RobertLWalton/RobertLWalton.github.io/LSC/North-Acton-Map/North-Acton-2023-08-13-Spring-Hill-5.pdf

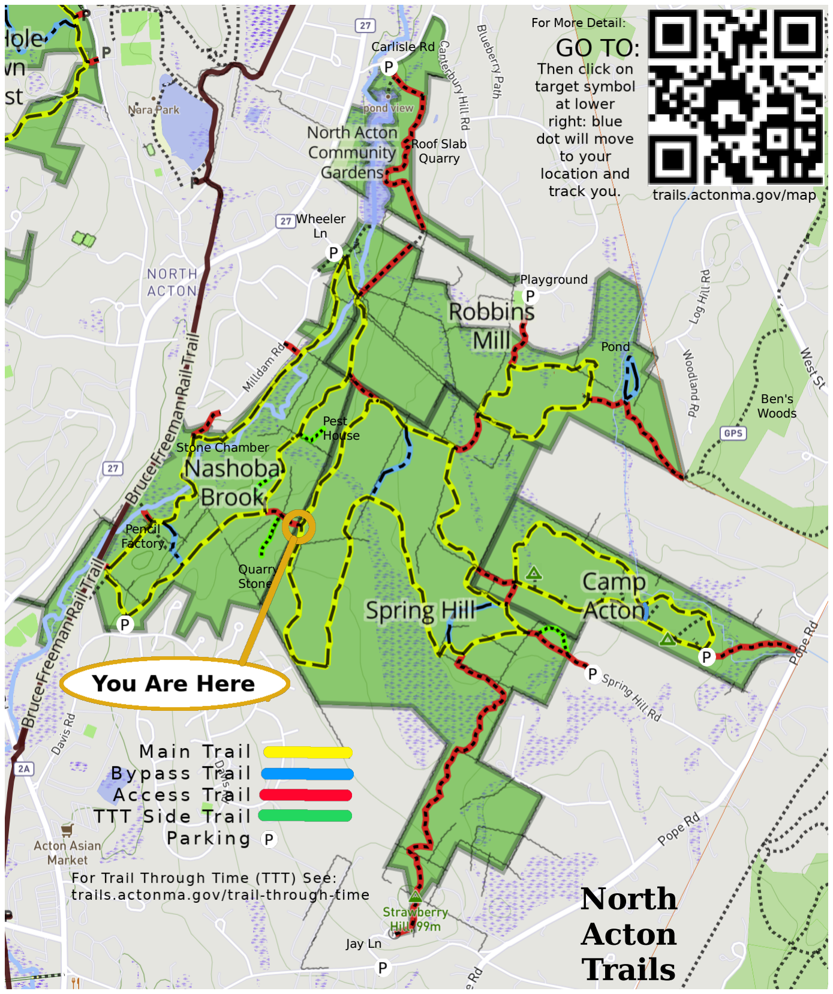
[picture p23: page 1]

Carlisle Rd

Playground

Wheeler
Ln

Pond

Pest
House
Stone Chamber

Quarry
Stone

Pencil
Factory

Jay Ln

Ben's
Woods

Roof Slab
Quarry

# North Acton Trails
