RobertLWalton/RobertLWalton.github.io/LSC/North-Acton-Map/North-Acton-2023-08-13-Robbins-Mill-3.pdf

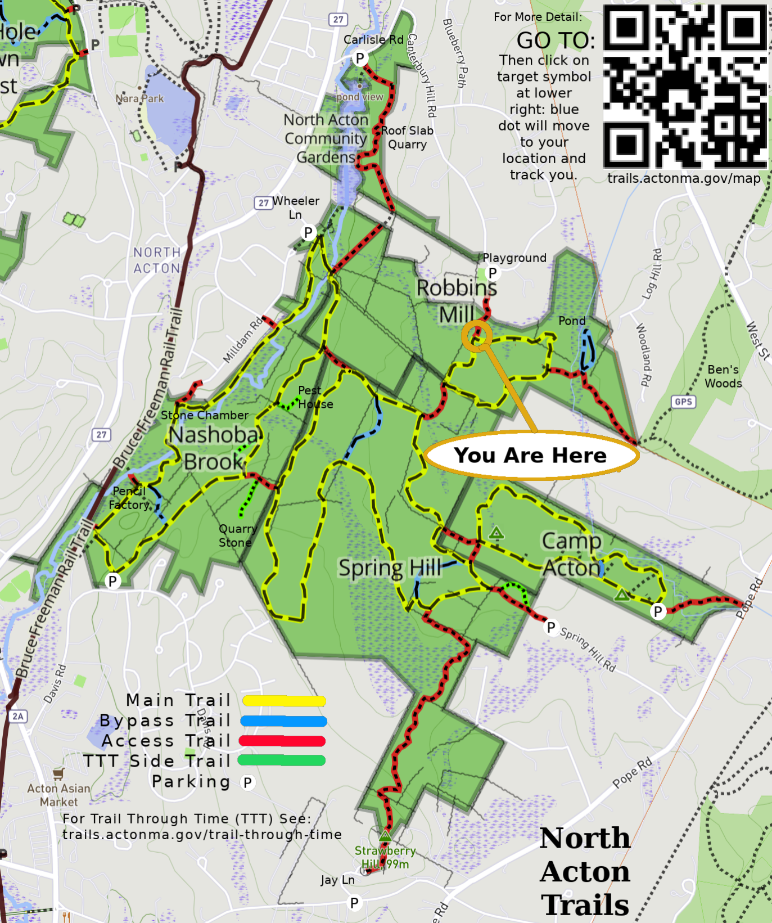
[picture p24: page 1]
