RobertLWalton/RobertLWalton.github.io/LSC/Wills-Hole-Map/Wills-Hole-2025-04-04-4.pdf

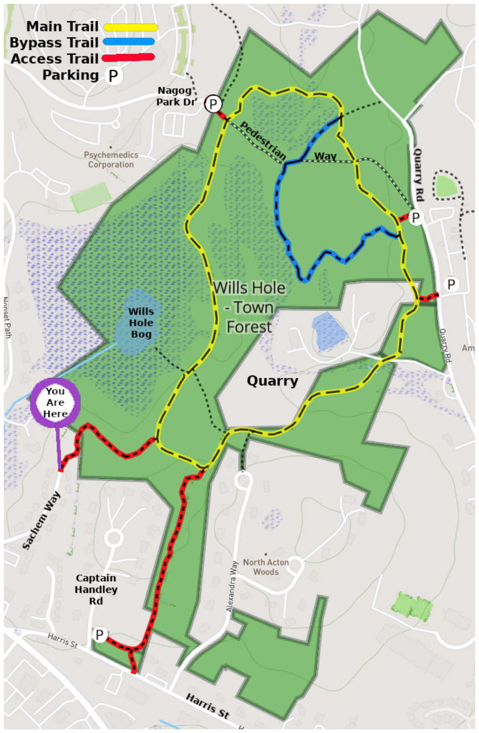
[picture p25: page 1]
