RobertLWalton/RobertLWalton.github.io/LSC/Wills-Hole-Map/Wills-Hole-2025-04-04-1.pdf

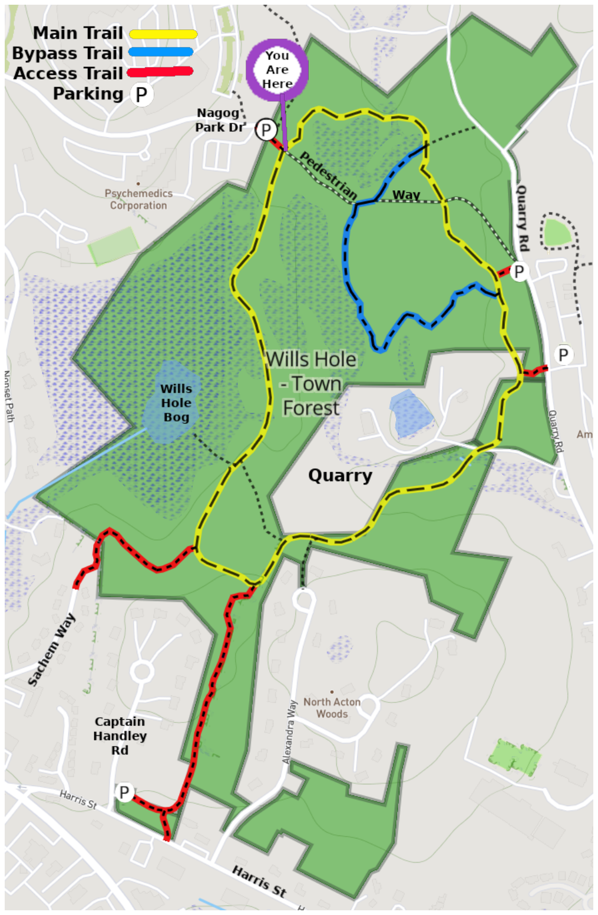
[picture p26: page 1]
