RobertLWalton/RobertLWalton.github.io/LSC/Wills-Hole-Map/Wills-Hole-2025-04-04-2.pdf

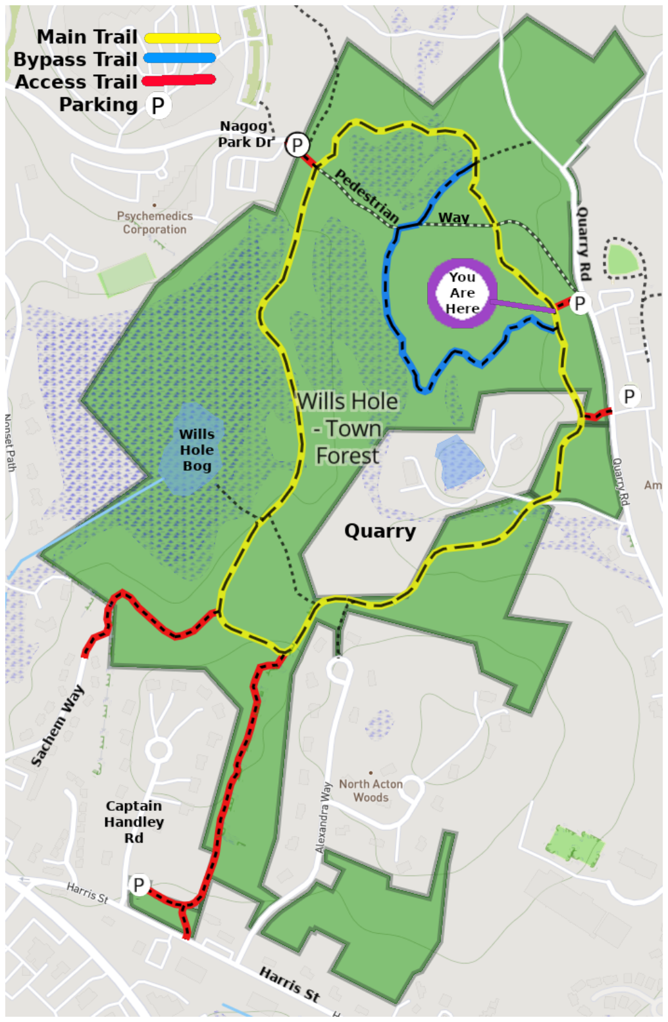
[picture p27: page 1]
