RobertLWalton/RobertLWalton.github.io/LSC/Wills-Hole-Map/Wills-Hole-2025-04-04-3.pdf

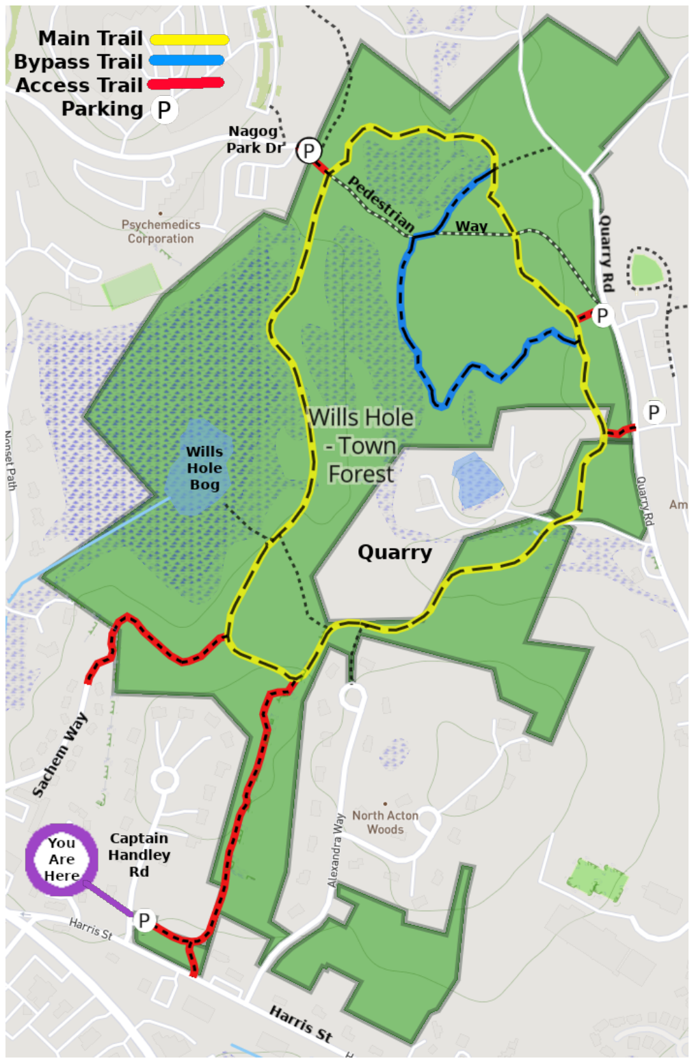
[picture p28: page 1]
