RobertLWalton/RobertLWalton.github.io/LSC/Wills-Hole-Map/Wills-Hole-Labeled-Here.pdf

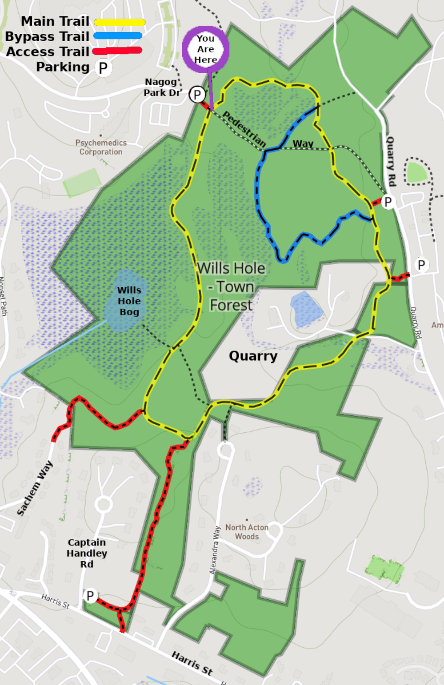
[picture p29: page 1]
