RobertLWalton/RobertLWalton.github.io/LSC/Wills-Hole-Map/Wills-Hole-Labeled.pdf

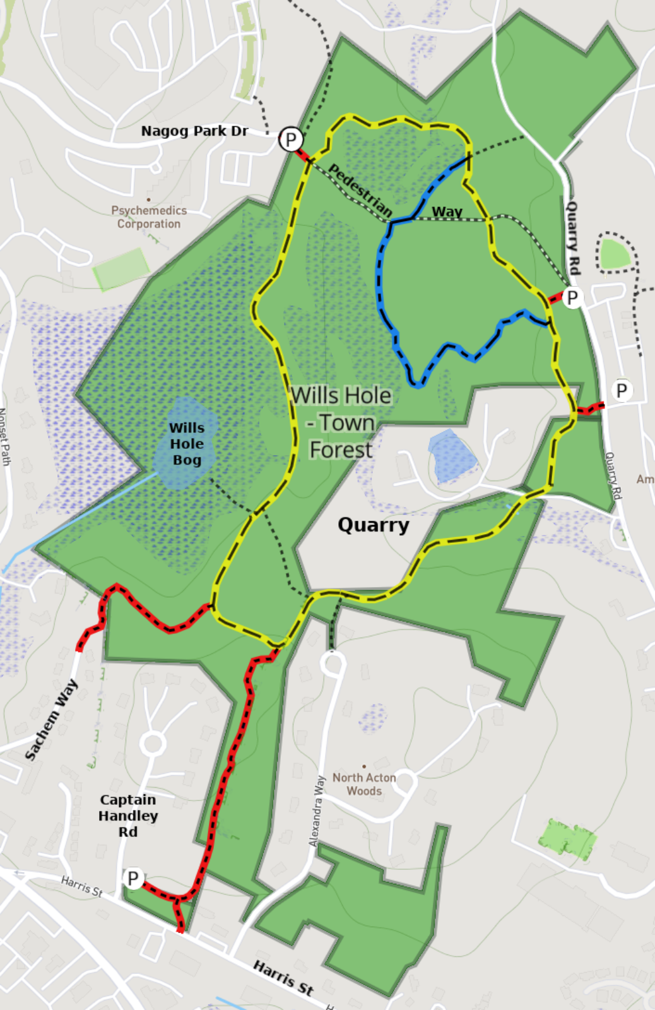
[picture p30: page 1]
