RobertLWalton/RobertLWalton.github.io/LSC/Wills-Hole-Map/Wills-Hole-Base.pdf

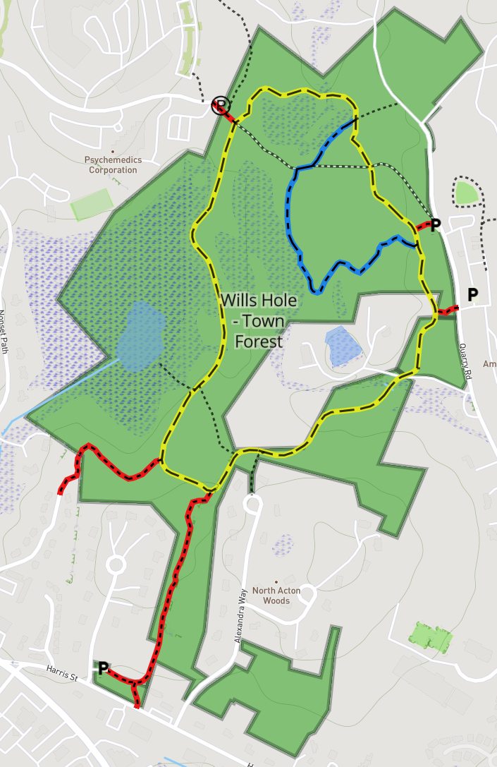
[picture p31: page 1]
