RobertLWalton/RobertLWalton.github.io/LSC/North-Acton-Map/North-Acton-2023-08-13-Spring-Hill-1.pdf

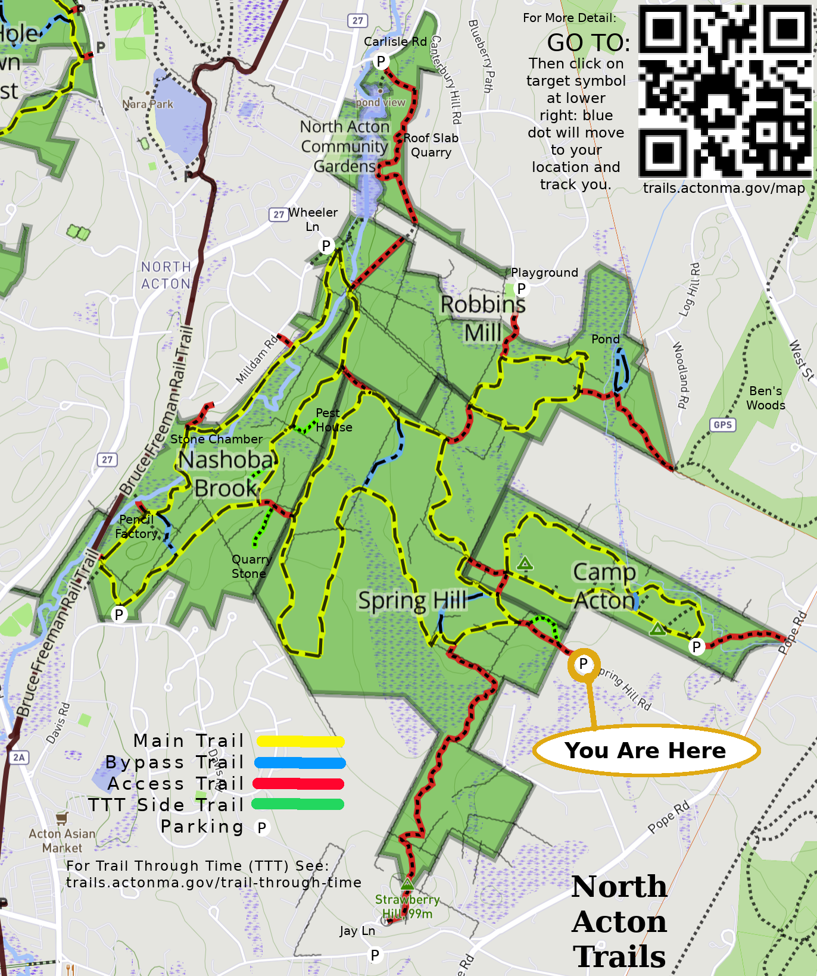
[picture p32: page 1]
