RobertLWalton/RobertLWalton.github.io/LSC/North-Acton-Map/North-Acton-2023-08-13-Spring-Hill-2.pdf

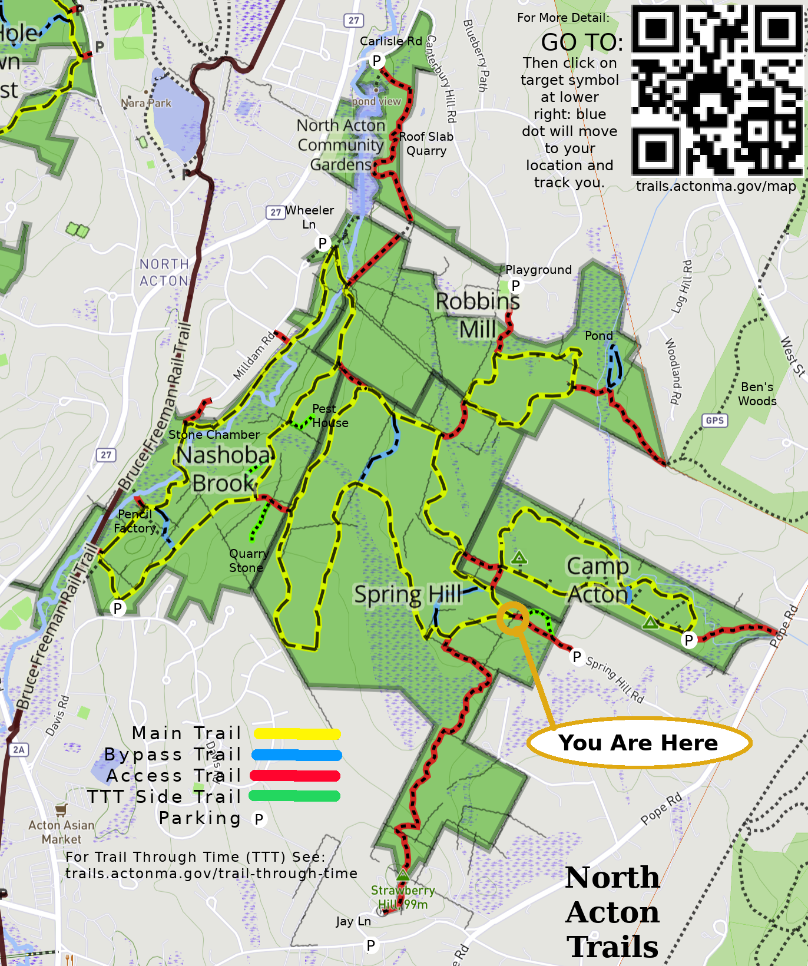
[picture p33: page 1]
