RobertLWalton/RobertLWalton.github.io/LSC/North-Acton-Map/North-Acton-2023-08-13-Spring-Hill-3.pdf

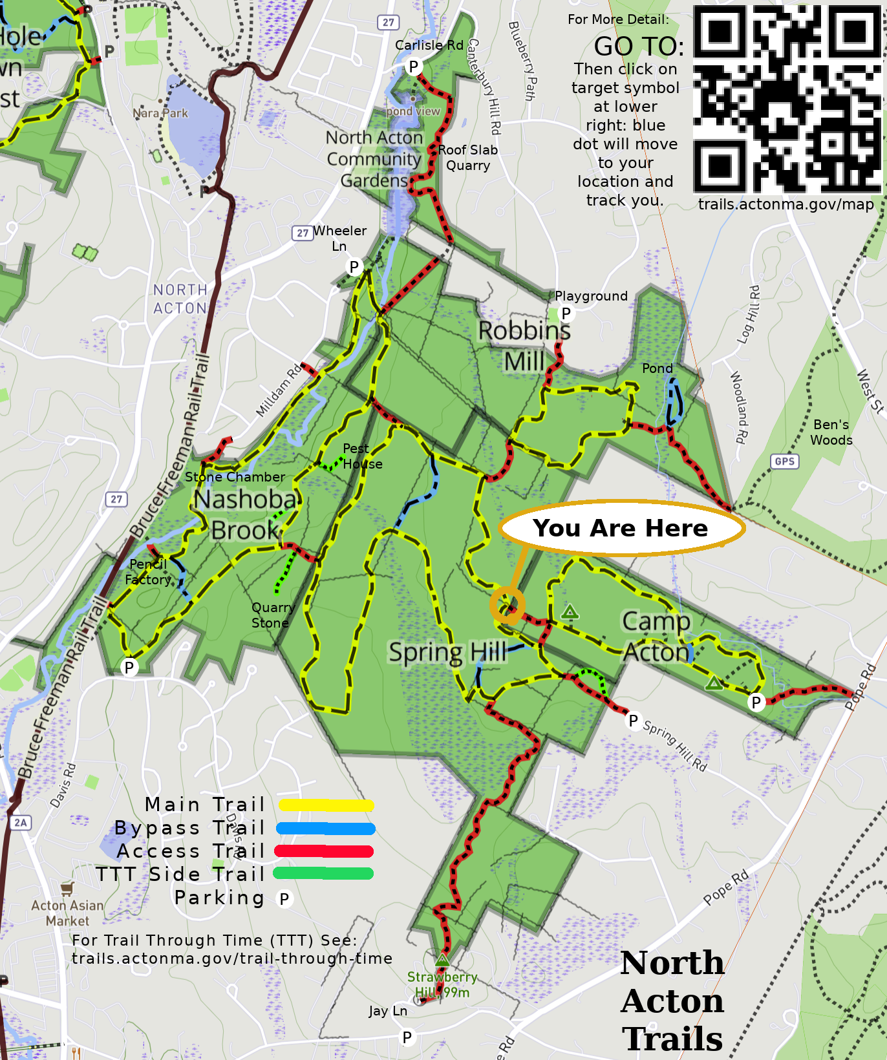
[picture p34: page 1]
