RobertLWalton/RobertLWalton.github.io/LSC/North-Acton-Map/North-Acton-2023-08-13-Spring-Hill-4.pdf

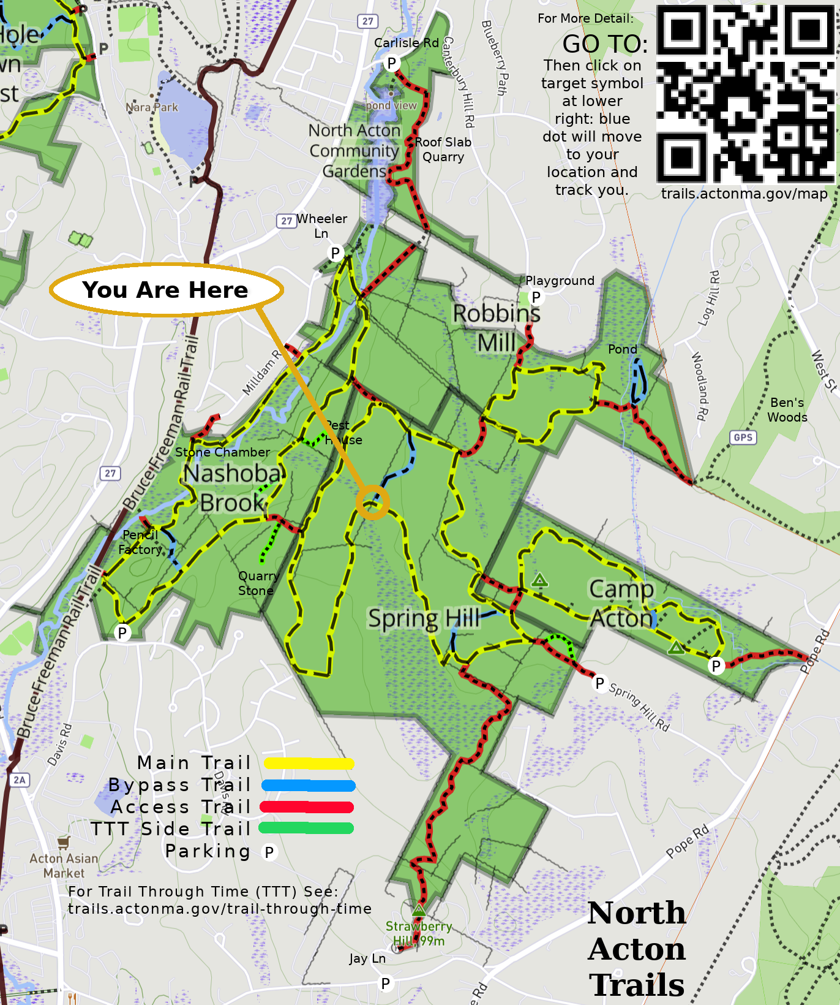
[picture p35: page 1]
