RobertLWalton/RobertLWalton.github.io/LSC/North-Acton-Map/North-Acton-2023-08-13-Robbins-Mill-1.pdf

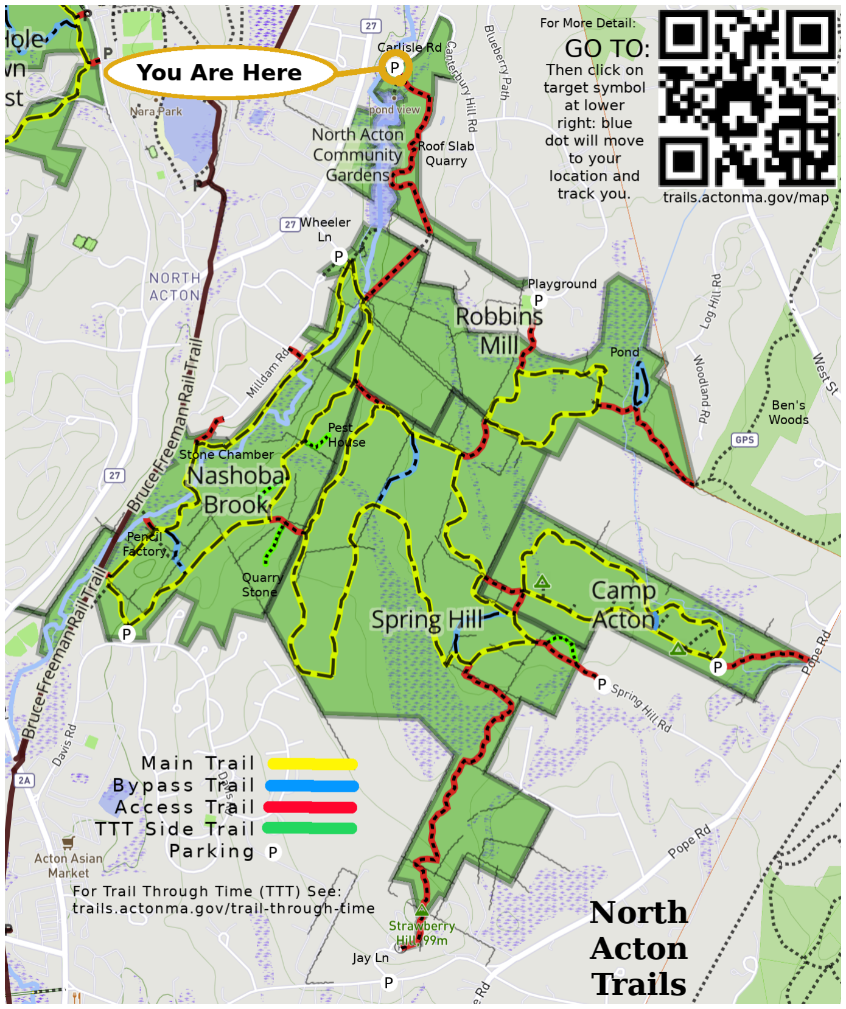
[picture p36: page 1]
