RobertLWalton/RobertLWalton.github.io/LSC/North-Acton-Map/North-Acton-2023-08-13-Robbins-Mill-2.pdf

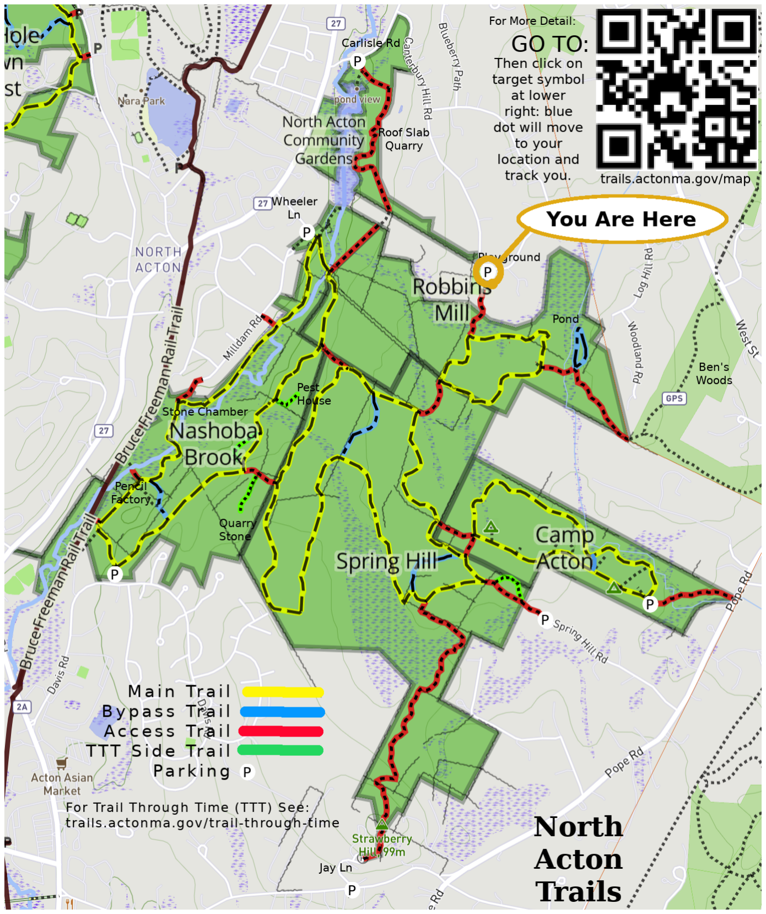
[picture p37: page 1]
