RobertLWalton/RobertLWalton.github.io/LSC/North-Acton-Map/North-Acton-2023-08-13-Labelled-with-Blue-Trail.pdf

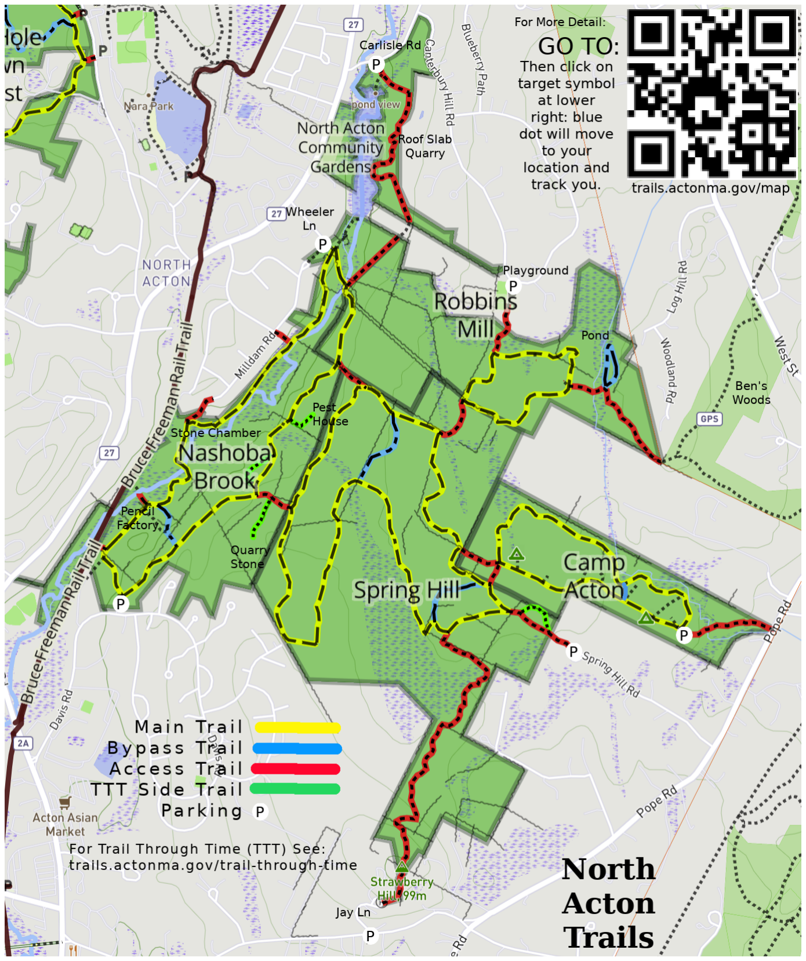
[picture p39: page 1]
