RobertLWalton/RobertLWalton.github.io/LSC/robbins-mill/scout-trust-land/scout-trust-re-route-map.pdf

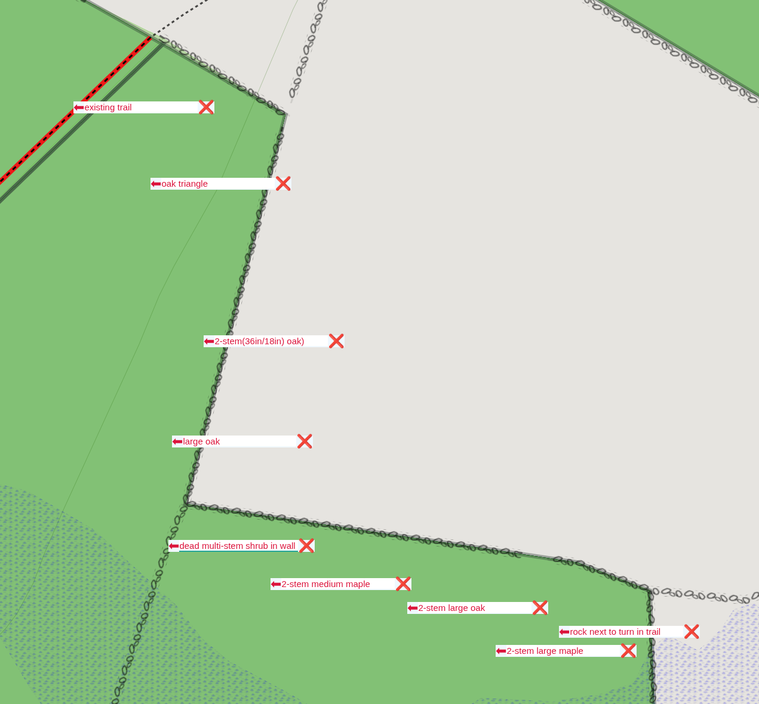
[picture p40: page 1]
