RobertLWalton/RobertLWalton.github.io/LSC/robbins-mill/scout-trust-land/scout-trust-re-route.pdf

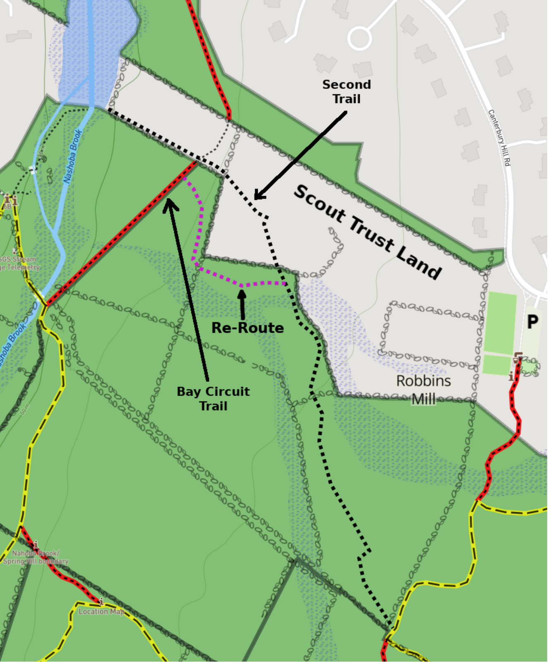
[picture p41: page 1]
