RobertLWalton/RobertLWalton.github.io/LSC/robbins-mill/scout-trust-land/scout-trust-land.pdf

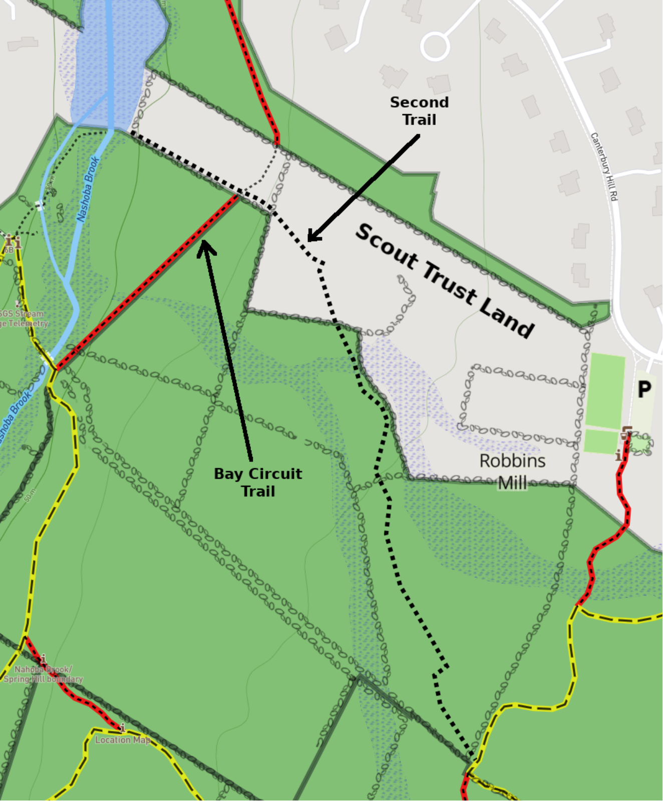
[picture p42: page 1]
