RobertLWalton/RobertLWalton.github.io/LSC/boardwalk/Boardwalk-bottom.png

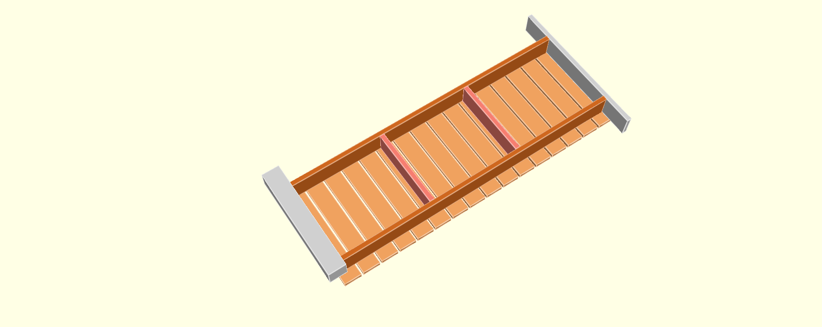
LSC/boardwalk/Boardwalk-bottom.png
