RobertLWalton/RobertLWalton.github.io/LSC/boardwalk/Boardwalk-end.png

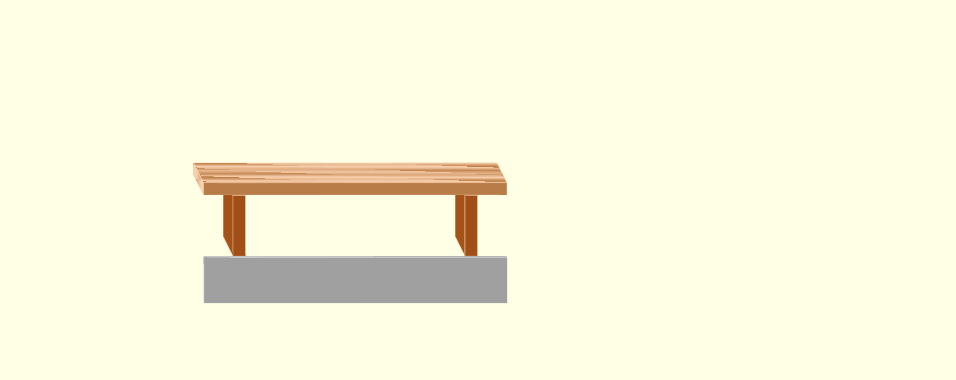
LSC/boardwalk/Boardwalk-end.png
