RobertLWalton/RobertLWalton.github.io/LSC/boardwalk/Boardwalk-side.png

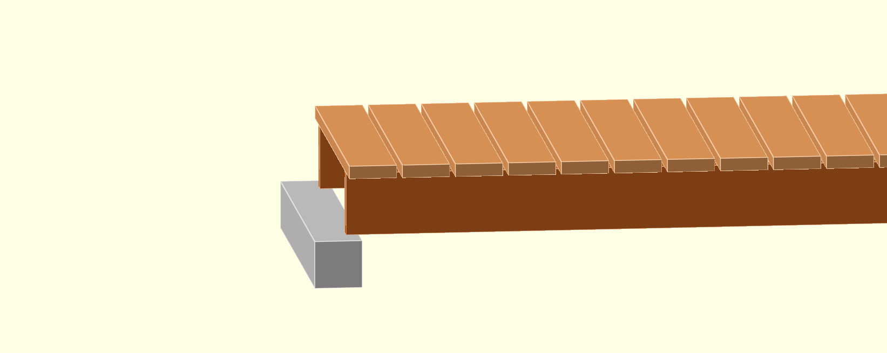
LSC/boardwalk/Boardwalk-side.png
