RobertLWalton/RobertLWalton.github.io/LSC/boardwalk/Boardwalk-sill-height.png

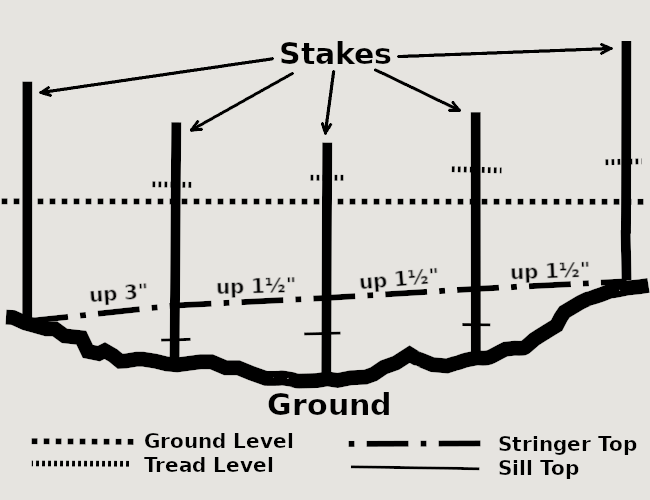
LSC/boardwalk/Boardwalk-sill-height.png
