RobertLWalton/RobertLWalton.github.io/LSC/boardwalk/Boardwalk-top.png

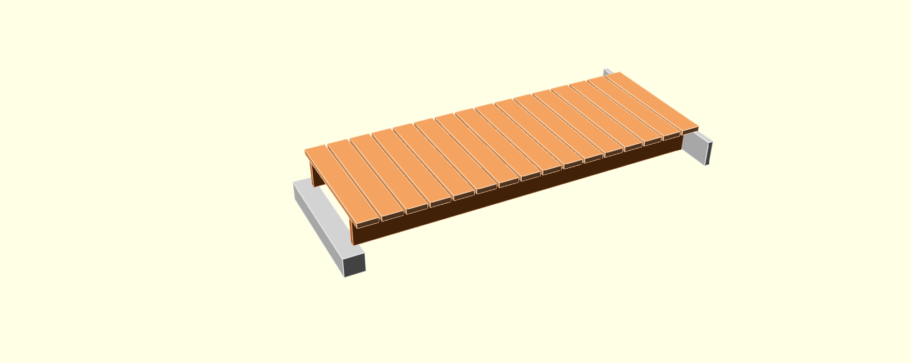
LSC/boardwalk/Boardwalk-top.png
