RobertLWalton/RobertLWalton.github.io/LSC/boardwalk/corner-long-stringers.png

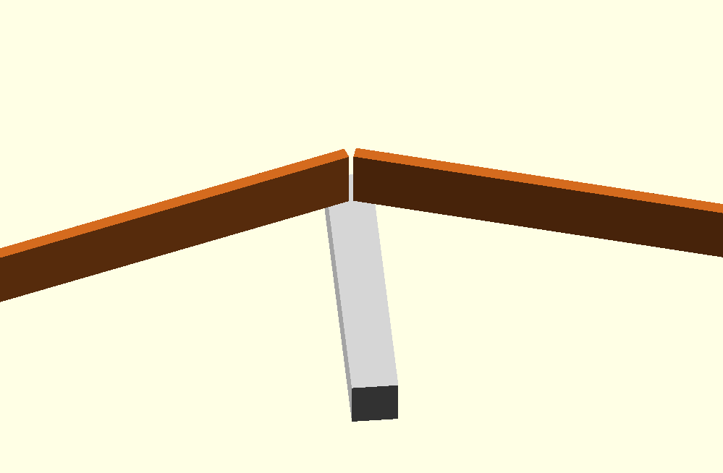
LSC/boardwalk/corner-long-stringers.png
