RobertLWalton/RobertLWalton.github.io/LSC/boardwalk/corner-stringers.png

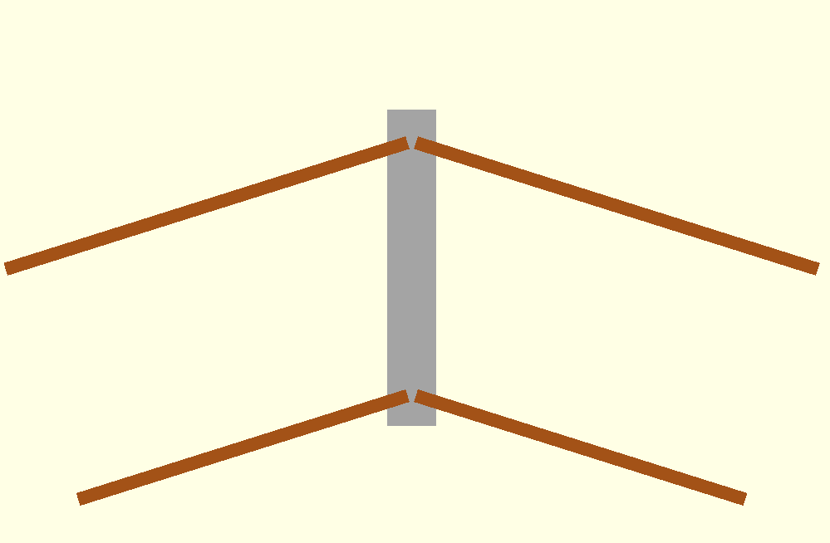
LSC/boardwalk/corner-stringers.png
