RobertLWalton/RobertLWalton.github.io/LSC/boardwalk/corner-treads.png

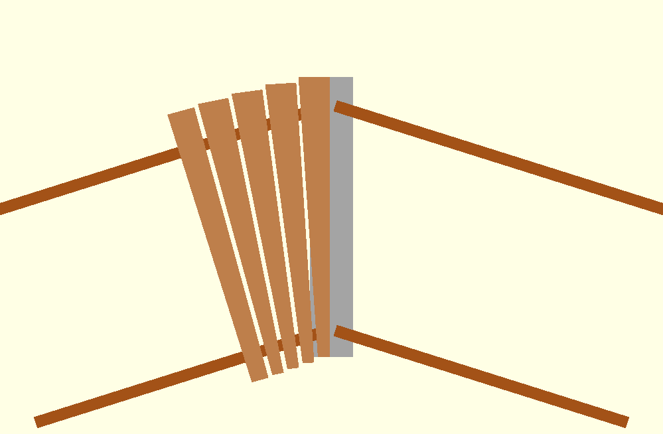
LSC/boardwalk/corner-treads.png
