RobertLWalton/RobertLWalton.github.io/LSC/boardwalk/corner.png

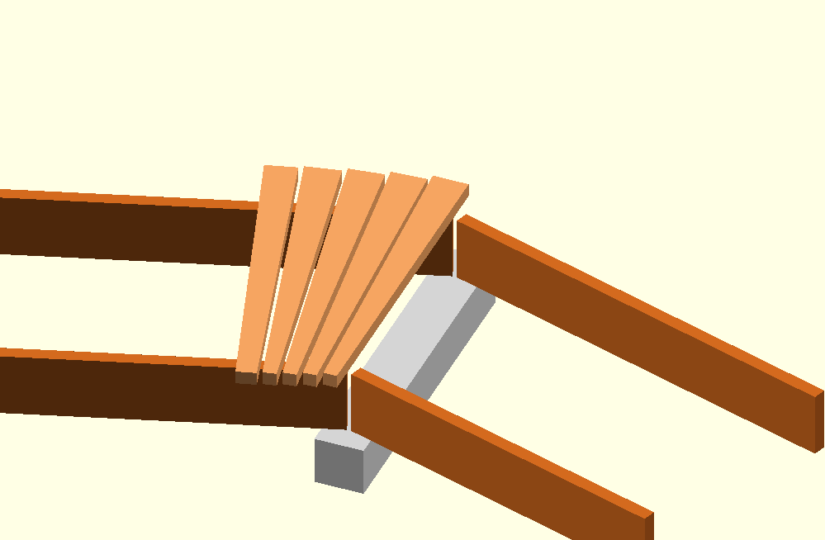
LSC/boardwalk/corner.png
