RobertLWalton/RobertLWalton.github.io/LSC/boardwalk/stringer-length.png

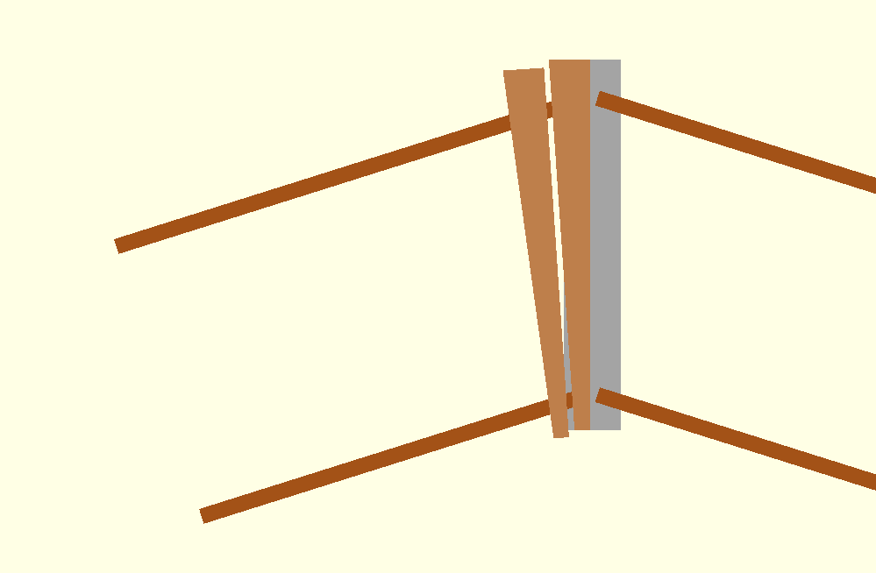
LSC/boardwalk/stringer-length.png
