RobertLWalton/RobertLWalton.github.io/LSC/boardwalk/tapered.png

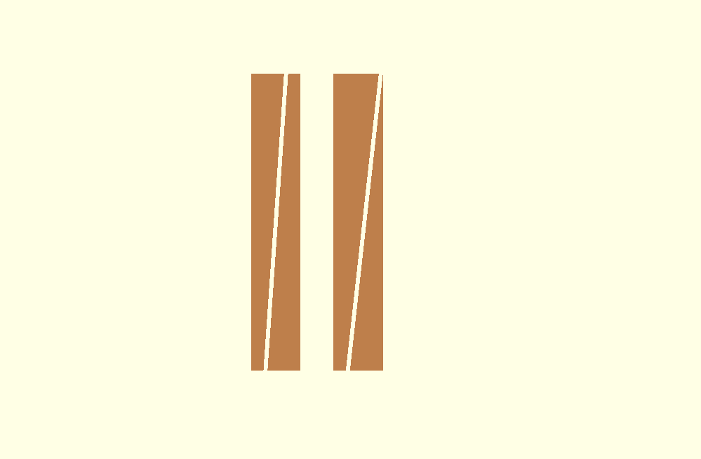
LSC/boardwalk/tapered.png
