RobertLWalton/RobertLWalton.github.io/LSC/bridge/Bridge-CAD.png

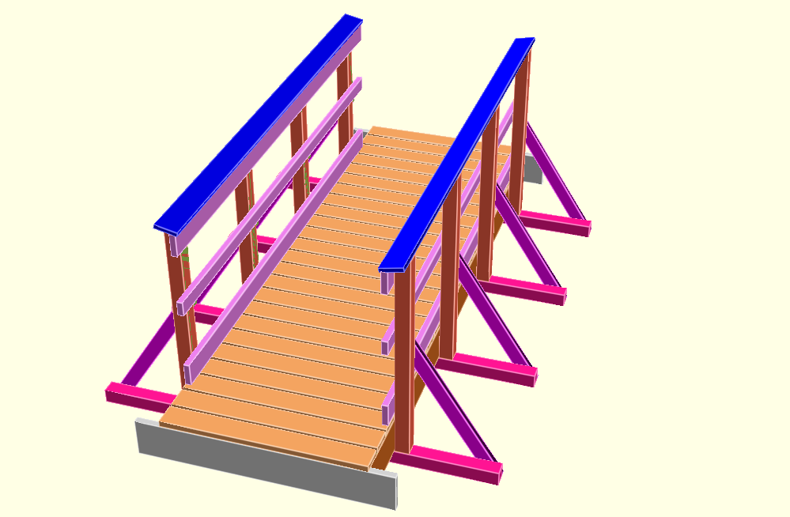
LSC/bridge/Bridge-CAD.png
