RobertLWalton/RobertLWalton.github.io/LSC/bridge/Bridge-Frame-Bottom-CAD.png

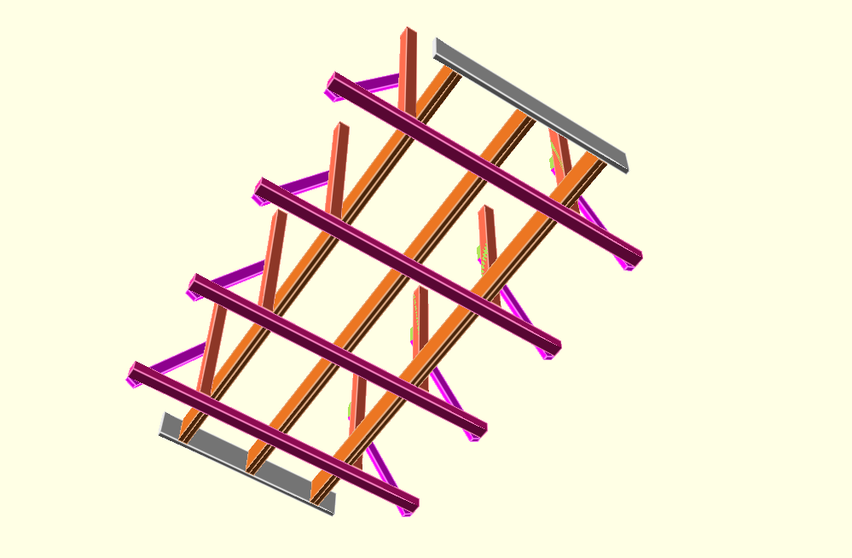
LSC/bridge/Bridge-Frame-Bottom-CAD.png
