RobertLWalton/RobertLWalton.github.io/LSC/bridge/Bridge-Frame-Bottom.png

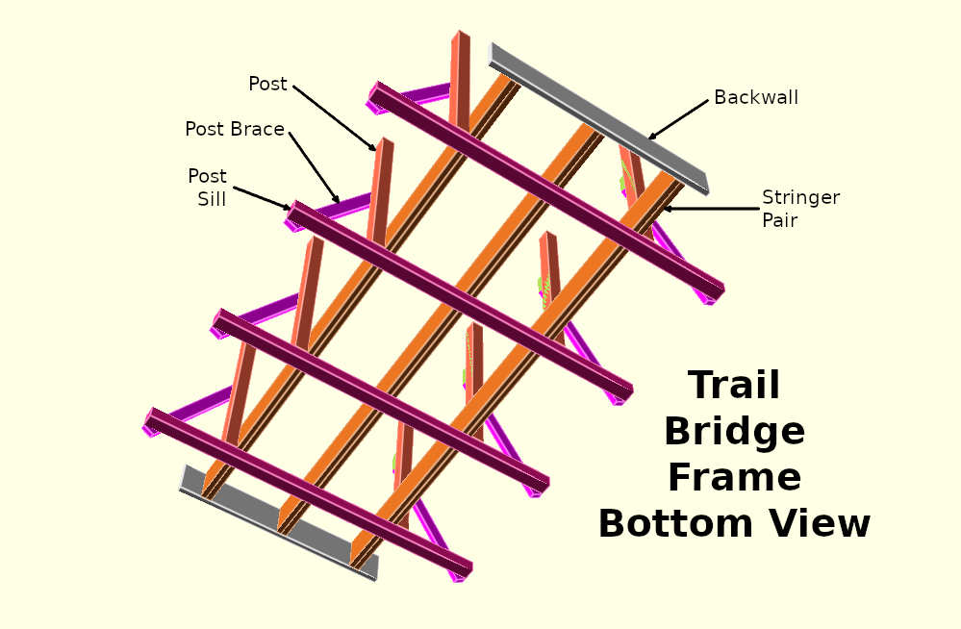
LSC/bridge/Bridge-Frame-Bottom.png
