RobertLWalton/RobertLWalton.github.io/LSC/bridge/Bridge-Frame-Rails-Caps.png

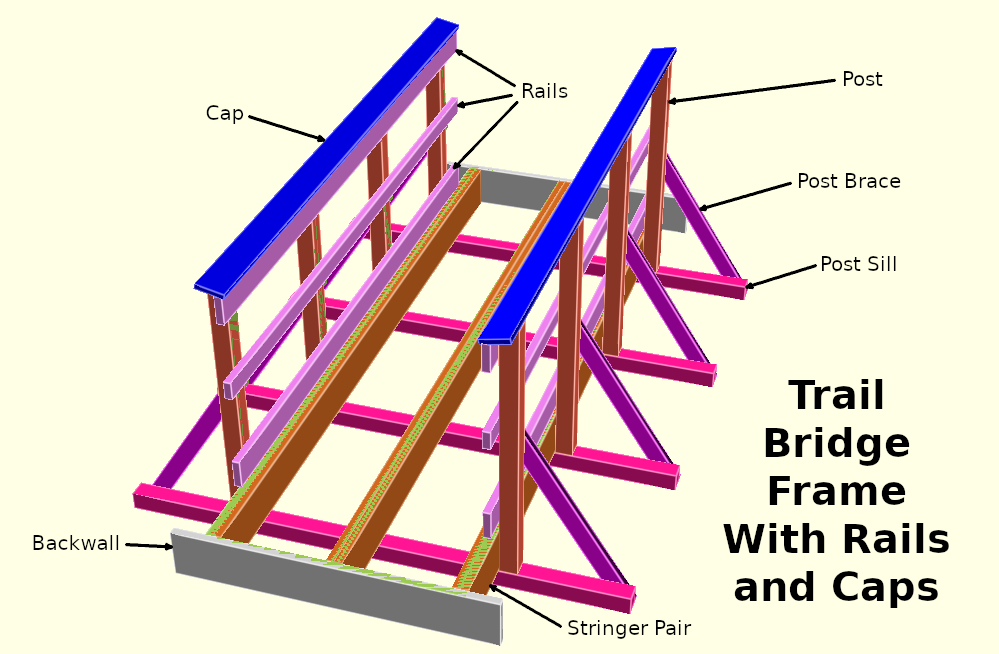
LSC/bridge/Bridge-Frame-Rails-Caps.png
