RobertLWalton/RobertLWalton.github.io/LSC/bridge/Bridge-Frame-Top-CAD.png

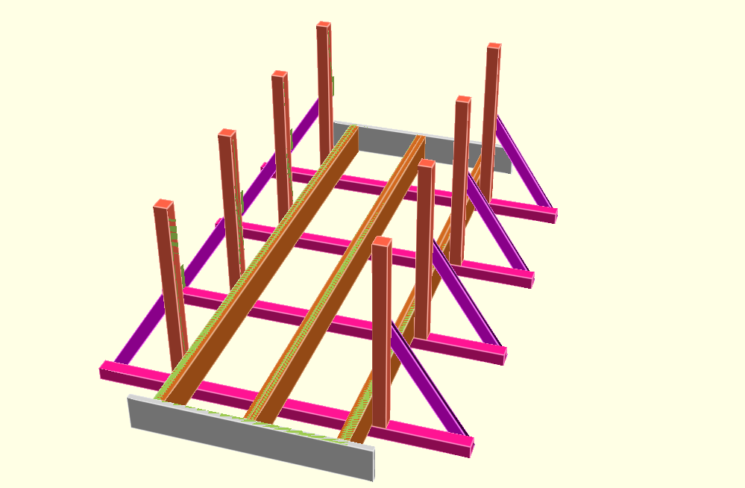
LSC/bridge/Bridge-Frame-Top-CAD.png
