RobertLWalton/RobertLWalton.github.io/LSC/bridge/Bridge-Frame-Top.png

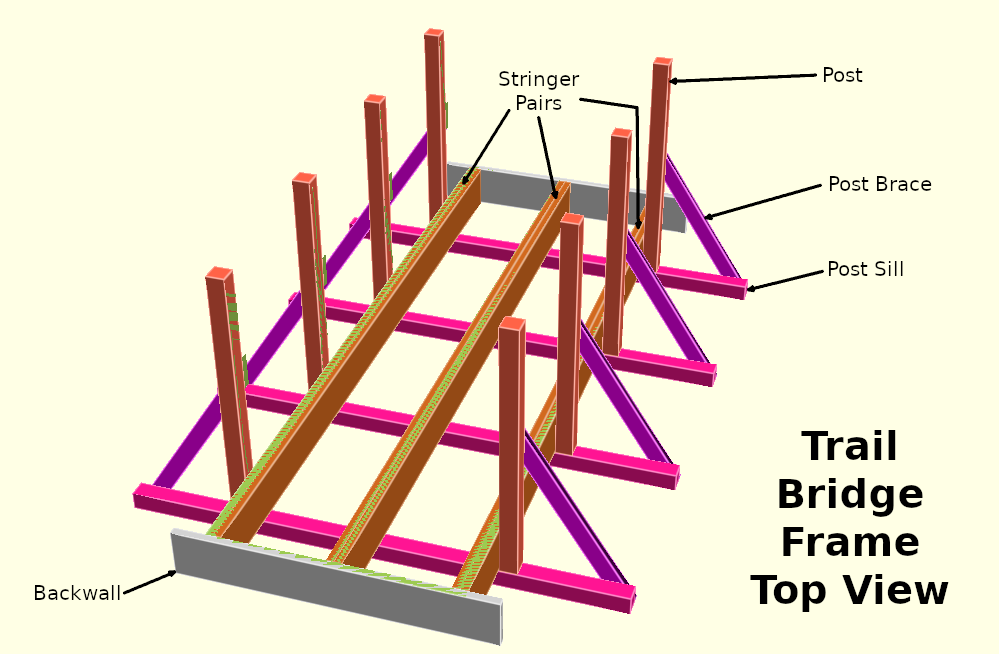
LSC/bridge/Bridge-Frame-Top.png
