RobertLWalton/RobertLWalton.github.io/LSC/bridge/EPC4Z-Bare.png

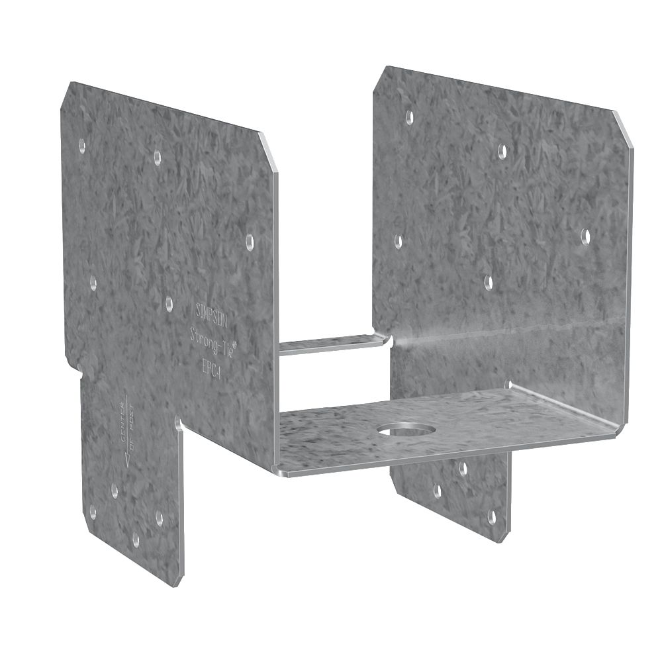
LSC/bridge/EPC4Z-Bare.png
