RobertLWalton/RobertLWalton.github.io/LSC/bridge/EPC4Z.png

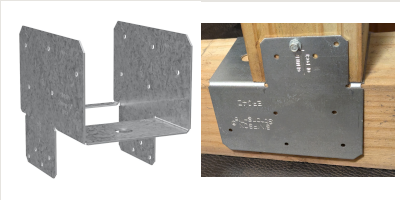
LSC/bridge/EPC4Z.png
