RobertLWalton/RobertLWalton.github.io/LSC/bridge/LPC4Z-Bare.png

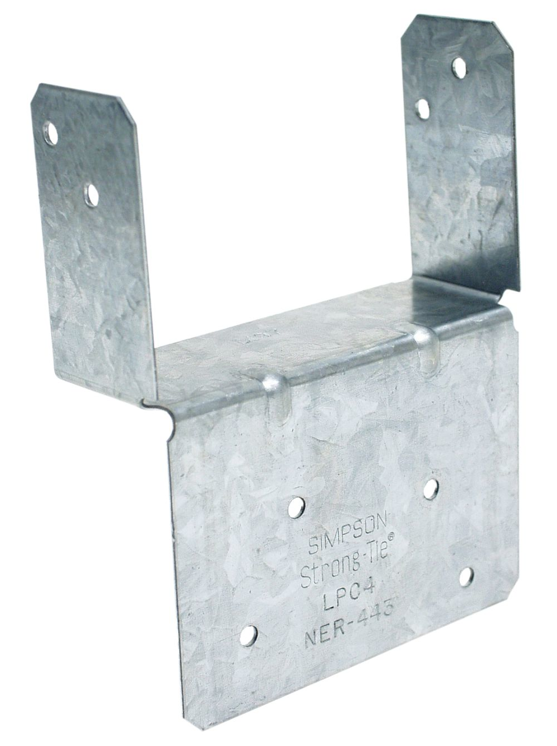
LSC/bridge/LPC4Z-Bare.png
