RobertLWalton/RobertLWalton.github.io/LSC/Heath-Hen-Map/Heath-Hen-Base.png

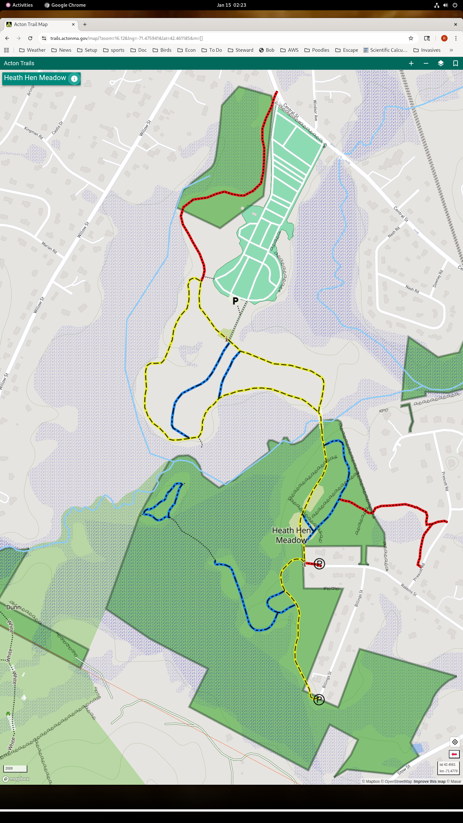
LSC/Heath-Hen-Map/Heath-Hen-Base.png
