RobertLWalton/RobertLWalton.github.io/LSC/robbins-mill/scout-trust-land/scout-trust-land-original.png

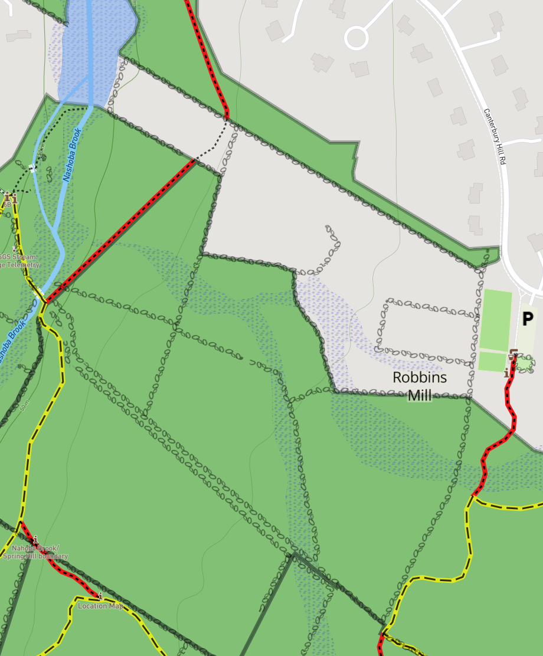
LSC/robbins-mill/scout-trust-land/scout-trust-land-original.png
