RobertLWalton/RobertLWalton.github.io/LSC/robbins-mill/scout-trust-land/scout-trust-openstreet.png

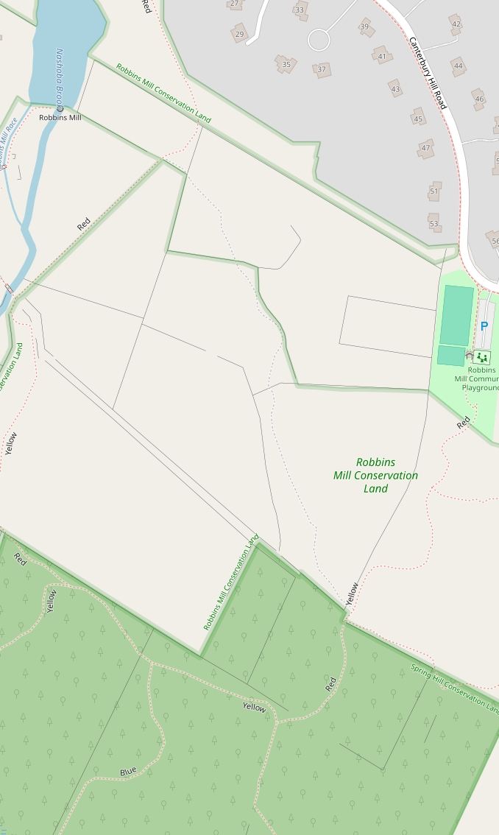
LSC/robbins-mill/scout-trust-land/scout-trust-openstreet.png
