RobertLWalton/RobertLWalton.github.io/LSC/Wills-Hole-Map/Wills-Hole-Base.png

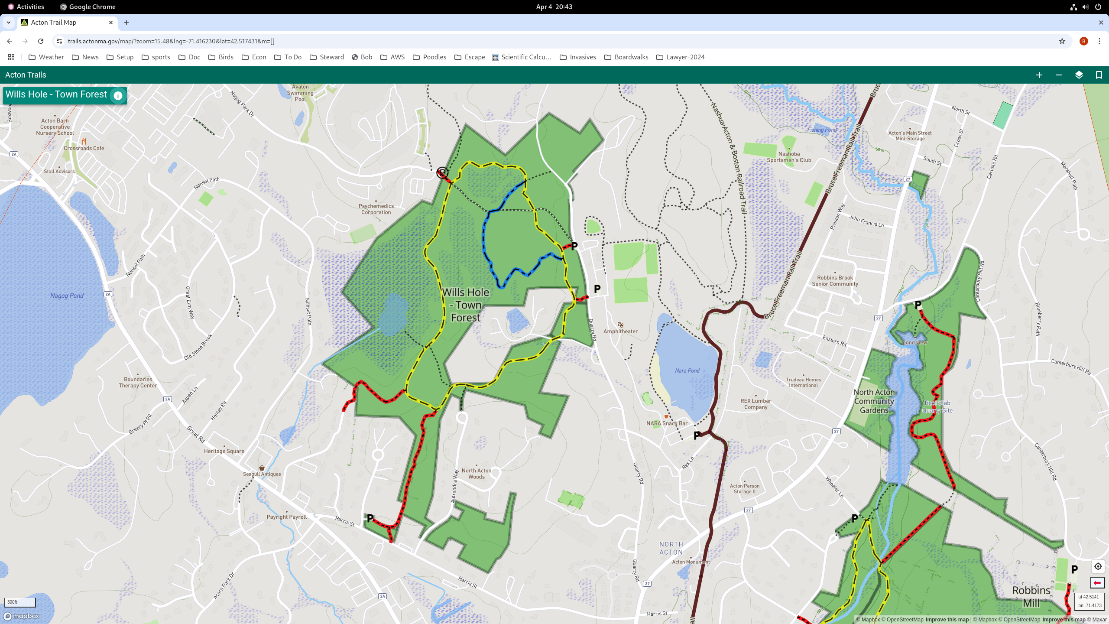
LSC/Wills-Hole-Map/Wills-Hole-Base.png
