RobertLWalton/RobertLWalton.github.io/LSC/bridge/EPC4Z-Installed.png

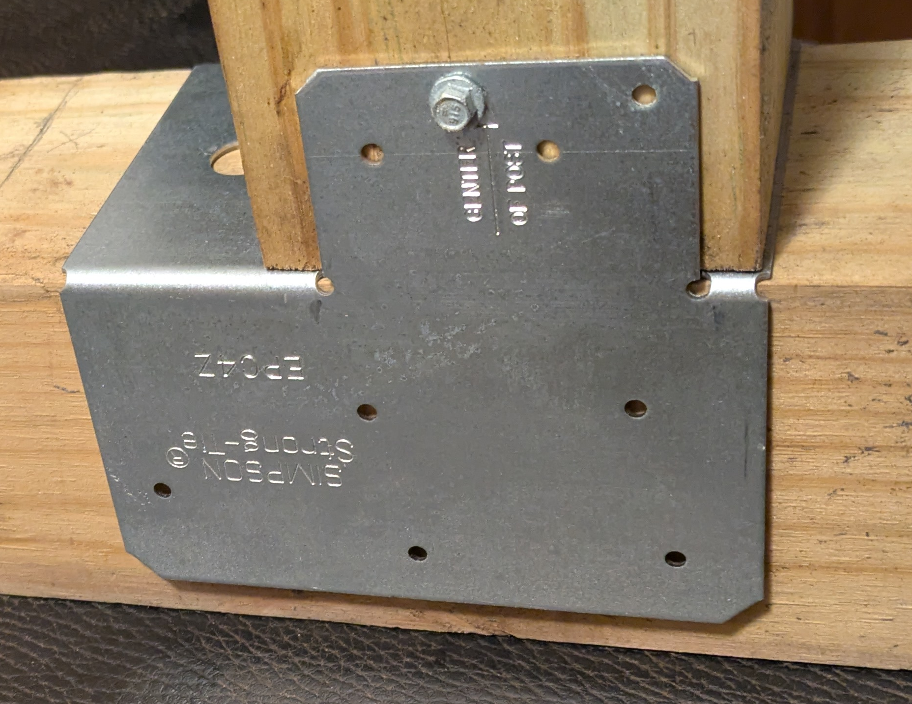
LSC/bridge/EPC4Z-Installed.png
