RobertLWalton/RobertLWalton.github.io/LSC/guide/bent-t-strap.png

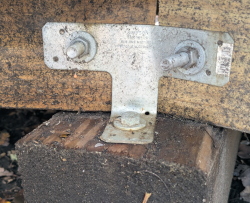
LSC/guide/bent-t-strap.png
