RobertLWalton/RobertLWalton.github.io/LSC/guide/green-side-up.jpg

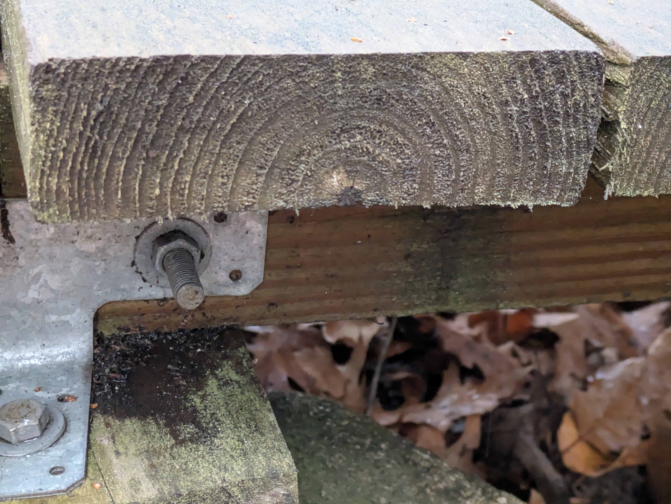
LSC/guide/green-side-up.jpg
