RobertLWalton/RobertLWalton.github.io/LSC/guide/heartwood-side-up.jpg

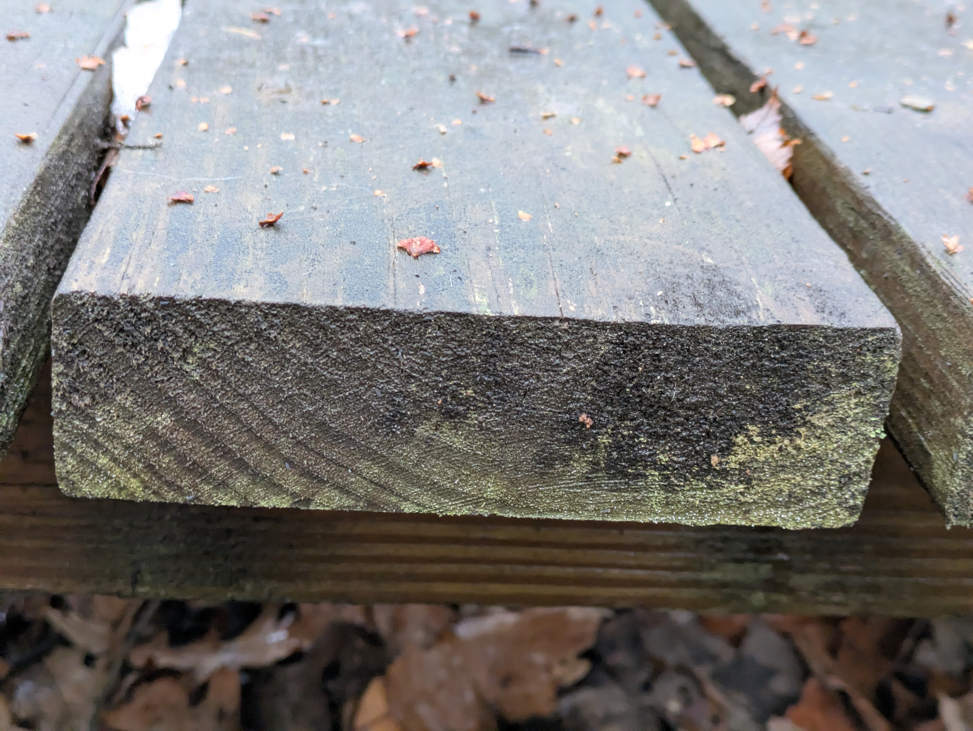
LSC/guide/heartwood-side-up.jpg
