RobertLWalton/RobertLWalton.github.io/LSC/guide/t-strap.jpg

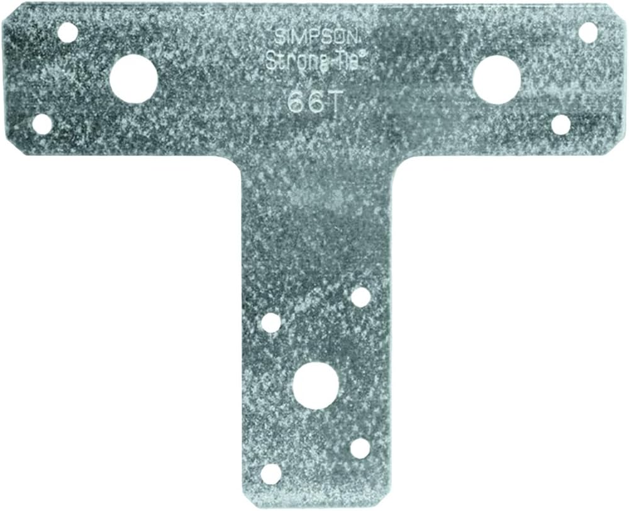
LSC/guide/t-strap.jpg
