RobertLWalton/RobertLWalton.github.io/LSC/guide/t-strap.png

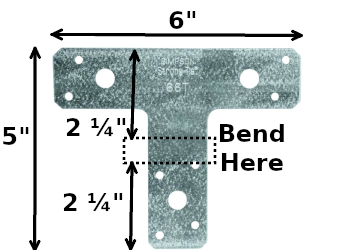
LSC/guide/t-strap.png
