RobertLWalton/RobertLWalton.github.io/LSC/guide/treads-with-wane.jpg

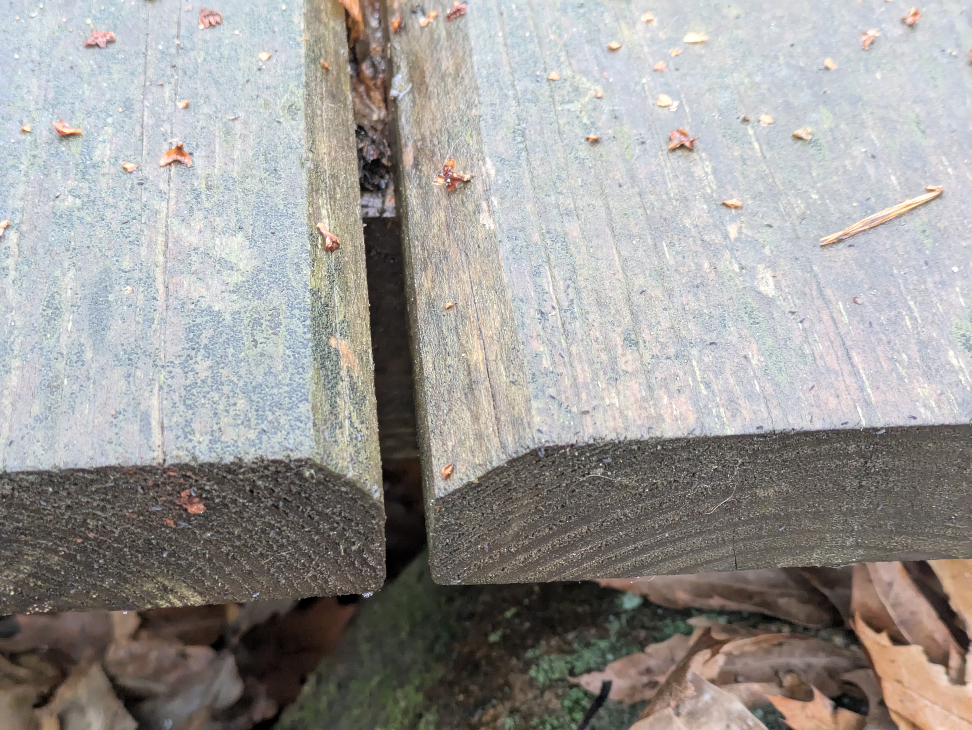
LSC/guide/treads-with-wane.jpg
