RobertLWalton/RobertLWalton.github.io/LSC/location-experiment-2023/Nashoba-Directory.html

# Nashoba Conservation Area

After accessing the interactive map below, you should immediately press the locator button (looks something like the target ⌖) in the lower right corner of the map. A blue dot will appear and move (often slowly) to your location. It will then track your location as long as your screen is activated.

Proceed to one of:

Interactive Trail Map (https://trails.actonma.gov/map/?zoom=14.41&lng=-71.407893&lat=42.507677&m=[])
Trail Through Time Information (https://trails.actonma.gov/trail-through-time/)
Nashoba Brook Conservation Area Information (https://trails.actonma.gov/nashoba-brook/)
Alternative Directory (http://walton-at-acm.org-acton-lsc.s3-website-us-east-1.amazonaws.com/Nashoba-Directory.html)
